Hemonel/Cyclone-III-procesado-digital/(list of files, cad)

Other CAD files:
apartados/ampliacion1/simulation/modelsim/rtl_work/clkout/syn.psm
apartados/ampliacion1/simulation/modelsim/rtl_work/clkout_altpll/verilog.psm
apartados/ampliacion1/simulation/modelsim/rtl_work/contador/algoritmo.psm
apartados/ampliacion1/simulation/modelsim/rtl_work/divisor_reloj/decripcion.psm
apartados/ampliacion1/simulation/modelsim/rtl_work/impulso_ini/comportamiento.psm
apartados/ampliacion1/simulation/modelsim/rtl_work/mem_fifo/guarda.psm
apartados/ampliacion1/simulation/modelsim/rtl_work/procesador_2/circuito.psm
apartados/ampliacion1/simulation/modelsim/rtl_work/reg_des/circuito.psm
apartados/ampliacion1/simulation/modelsim/rtl_work/spi_adc/comportamiento.psm
apartados/ampliacion1/simulation/modelsim/rtl_work/spi_dac/circuito.psm
apartados/ampliacion1/simulation/modelsim/rtl_work/uc_spi_out/comportamiento.psm
apartados/ampliacion2/simulation/modelsim/rtl_work/clkout/syn.psm
apartados/ampliacion2/simulation/modelsim/rtl_work/clkout_altpll/verilog.psm
apartados/ampliacion2/simulation/modelsim/rtl_work/contador/algoritmo.psm
apartados/ampliacion2/simulation/modelsim/rtl_work/divisor_reloj/decripcion.psm
apartados/ampliacion2/simulation/modelsim/rtl_work/impulso_ini/comportamiento.psm
apartados/ampliacion2/simulation/modelsim/rtl_work/mem_fifo/guarda.psm
apartados/ampliacion2/simulation/modelsim/rtl_work/procesador_2/circuito.psm
apartados/ampliacion2/simulation/modelsim/rtl_work/reg_des/circuito.psm
apartados/ampliacion2/simulation/modelsim/rtl_work/spi_adc/comportamiento.psm
apartados/ampliacion2/simulation/modelsim/rtl_work/spi_dac/circuito.psm
apartados/ampliacion2/simulation/modelsim/rtl_work/uc_spi_out/comportamiento.psm
apartados/ampliacion3/simulation/modelsim/rtl_work/clkout/syn.psm
apartados/ampliacion3/simulation/modelsim/rtl_work/clkout_altpll/verilog.psm
apartados/ampliacion3/simulation/modelsim/rtl_work/contador/algoritmo.psm
apartados/ampliacion3/simulation/modelsim/rtl_work/divisor_reloj/decripcion.psm
apartados/ampliacion3/simulation/modelsim/rtl_work/impulso_ini/comportamiento.psm
apartados/ampliacion3/simulation/modelsim/rtl_work/mem_fifo/guarda.psm
apartados/ampliacion3/simulation/modelsim/rtl_work/procesador_2/circuito.psm
apartados/ampliacion3/simulation/modelsim/rtl_work/reg_des/circuito.psm
apartados/ampliacion3/simulation/modelsim/rtl_work/spi_adc/comportamiento.psm
apartados/ampliacion3/simulation/modelsim/rtl_work/spi_dac/circuito.psm
apartados/ampliacion3/simulation/modelsim/rtl_work/uc_spi_out/comportamiento.psm
apartados/practica4/simulation/modelsim/gate_work/spi_adc/structure.psm
apartados/practica4/simulation/modelsim/rtl_work/clkout/syn.psm
apartados/practica4/simulation/modelsim/rtl_work/clkout_altpll/verilog.psm
apartados/practica4/simulation/modelsim/rtl_work/spi_adc/comportamiento.psm
apartados/practica5/simulation/modelsim/rtl_work/contador/algoritmo.psm
apartados/practica5/simulation/modelsim/rtl_work/divisor_reloj/decripcion.psm
apartados/practica5/simulation/modelsim/rtl_work/impulso_ini/comportamiento.psm
apartados/practica5/simulation/modelsim/rtl_work/reg_des/circuito.psm
apartados/practica5/simulation/modelsim/rtl_work/spi_dac/circuito.psm
apartados/practica5/simulation/modelsim/rtl_work/uc_spi_out/comportamiento.psm
