Hemonel/Cyclone-III-procesado-digital/(commit log)

2024-03-17 Update README.md, se añade la información faltante
2024-04-02 Update README.md añado foto del circuito montado y su esquema
